Davidandrei04/OrCAD-Capture-PSpice-PWM-Generator/(list of files, drawings)

Other design files:
root/pwm_copy_sim.dsn
root/pwm_copy_sim.opj
